Oliver276A/TinaThePageTurner/Final-Report.md

# Automatic Page Turner - Final Report

Dawson College - MakerSPACE  
Student Name: Oliver Mui  
Submitted to: Professor Joel Trudeau  
Date submitted: 2025-06-01    
       
[View on Github](https://github.com/Oliver276A/TinaThePageTurner/blob/main/Final-Report.md) or checkout the repository [here](https://github.com/Oliver276A/TinaThePageTurner).      

## 1. Introduction

One of the issues that bother many musicians is that of turning pages, which greatly inhibits their performance (to the point where in some concerts there is a dedicated person to turn the pages for the musician). Some use electronic tablets as a substitute but it is expensive and inconvenient for quick annotation. I believe that many musicians would like to be able to enjoy the convenience of having the pages turned for them while using their physical book or sheet music, and this inspired me to create this project, that is to create a prototype of an automatic page turner dedicated for musicians.   

This report will cover the planning, implementation and the results of this project, in an attempt to provide some insights on the development of such device.    

## 2. Project Description

### 2.1. Inspiration

The inspiration comes from my personal frustration over turning pages while trying to play a difficult piece. I do not own an electronic tablet, meaning my only options are to flip the pages myself or simply memorise the music.     

### 2.2. Objectives

Several similar projects exist but they present a few problems: Firstly, most of such projects are optimized for book reading and not for musicians, so they either lay completely flat, or they require an extensive setup. The one project that is made for the piano requires the pianist to attach special magnets. To me, all these reduce the attractiveness of page flipping machines to musicians.   

Thus, the goal of this project is to create a prototype of an **autonomatic** machine that is capable of turning pages while being **adapted to the needs of musicians**, that is:
- Lightweight and flexible for different needs
- Requires *minimal* setup and easy to use
- Simple, cheap and reliable
- Provides consistent result    

With limited resources, time and skills, I do not expect to create a perfectly functional machine. However, through the creation of a **basic prototype**, I hope to demonstrate that such device is feasible and can be perfected and developped into an real product, while sharing my experience which I hope would be of value to someone who wants to develop something similar.     

### 2.3. Design and Planning

The first question to answer, and this will prove to be the most important question, is how the pages should be picked up. Static electricity and magnets do not seem practical, so I decided to rely on the traditional mechanical method, which exist on many existing models - using a wheel to lift the pages.    

Then, when the pages are lifted, how should they be flipped to the left? My initial idea was to use a sliding bar. However, this will require gears and rails for the bar to slide upon, which are not only complicated, but can also end up being heavy. I opted for a stick attached to a servo in the end, which is simpler and more readily available.    

Some kind of user interaction is needed to trigger the page turn. I did not think about this in much detail as this can be any form of button or sensor depending on the need.    

Lastly, one single structure is needed to connect all these components. At first, inspired from book clips, I wanted to use those clips as the platform of my device, which allows for easy clipping to any books. However, upon further consideration, I discovered two problems: First, it would not work for books that lacks a hard cover which cannot support the weight of the device; Second, the device moves in such a big distance that a simple clip would not be enough.    

Thus, afterwards, I adopted the idea of a light platform to which books are clipped by a wheel and a stick which turn the pages. Tina "the Page" Turner was born.   

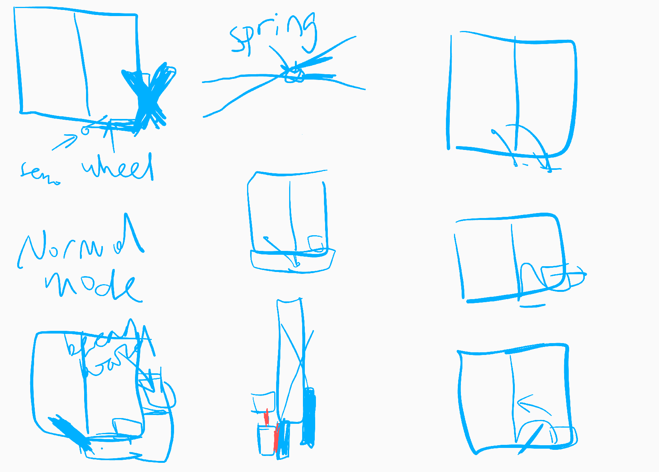
[picture p2: images/doodle.png]
Brainstorming doodle


## 3. Implementation

### 3.1. Hardware

- **Electronic Components**
    1. 180 degrees servo (Feetech FS90) - For the turning stick
    2. Continuous servo (Feetech FS90R) - For the wheel
    3. Ultrasonic sensor (HC-SR04) - Need I say more?   
- **Structural**
    1. Structural material of choice - I used some hard cardboard which is readily available but wood or metal will also work
    2. Adhesives - Some tape and some hot glue
    3. Torsion springs - This is to put pressure between the page and the wheel while allowing books to be placed on the platform; I realized it is very difficult to install torsion spring, so I came up with using a clothespeg which is readily available! (Note that the angle cannot be too small - More on this later.)
- **Tools**
    1. Scissors and cutters
    2. Hot glue gun

**Creating the Frame of the Machine**    
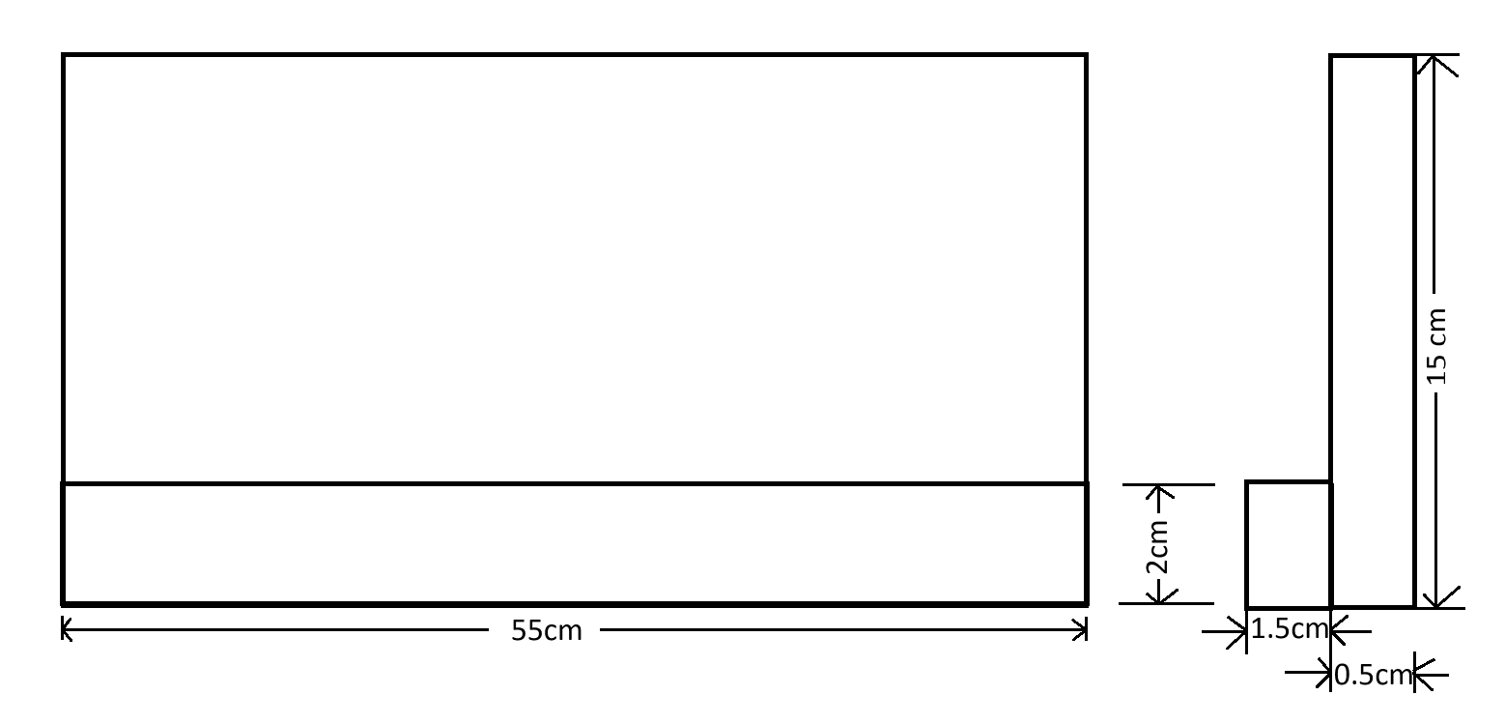
[picture p3: images/frame.png]
Diagram of the frame


**Installation of Electronic Components**   
              
*Overview*     
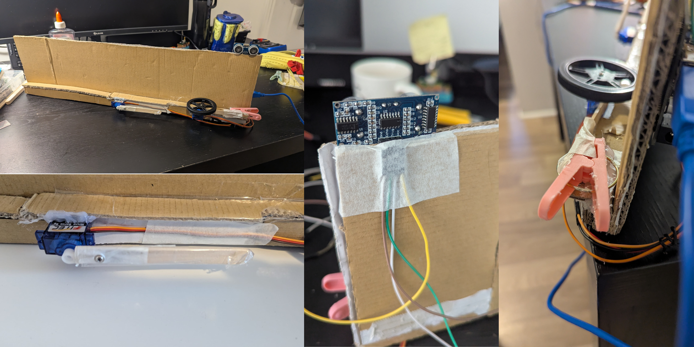
[picture p4: images/installation-photo.jpg]
Photo of Tina

*Ultrasonic sensor*    
- The ultrasonic sensor can be installed any way that is convenient
- I chose to tape the connectors on the top right of the frame simply because it is the easiest to install; It is also easy for a pianist to tilt their head to trigger the page turner     
       
*Stick*
- The stick is secured onto the 180 degree servo using a screw
- Note that the stick is wrapped with clear tape in order to make it smoother and prevent damaging the pages
- The ensemble is attached to the middle of the frame by hot glue      
         
*Wheel*
- The wheel must be secured onto the continuous servo using a screw, otherwise it could fall off
- The servo is attached to a stick, which itself is attached to the clothespeg using hot glue
- The clothespeg is attached to the horizontal platform such that the wheel touches the back platform
- A small triangular piece of cardboard was added to strengthen the connection     
          
*Arduino Uno and Breadboard*
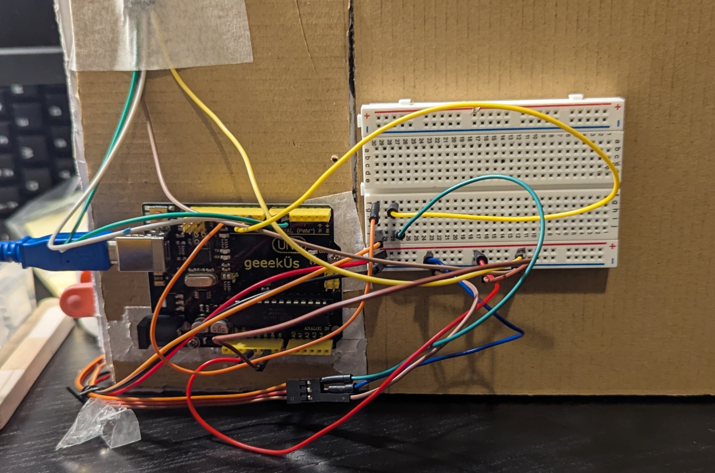
[picture p5: images/wiring-photo.jpg]
Wiring photo

- The Uno is secured by screws and the breadboard by adhesives
- The wires are hidden from view by placing the Uno and the breadboard in the back of the platform    

The wiring is shown in the following schematic:     
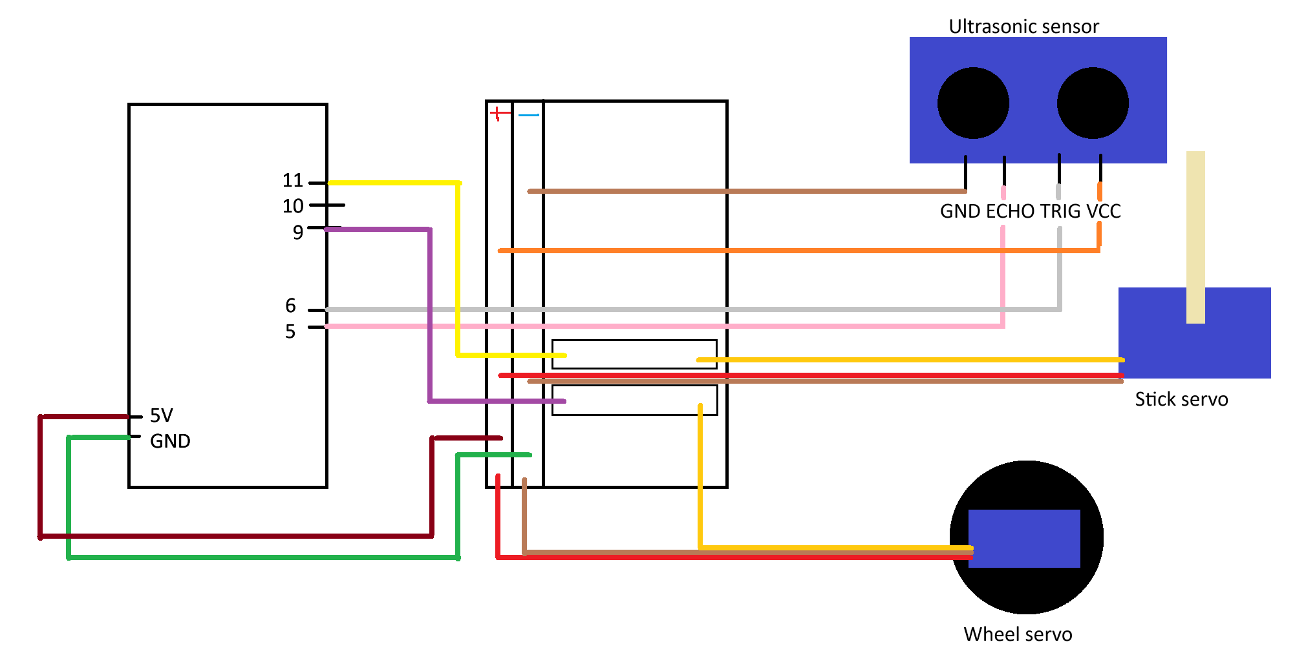
[picture p6: images/schematic.png]
Schematic diagram
  

Note that it is common practice to power servos with an external power supply, as the Arduino Uno does not provide sufficient current for the servos. However, during the course of this project, I did not notice significant power issues apart from the following: 1) The stick servo sometimes have trouble pushing the pages, especially when the page turner turns more than one pages by accident, and 2) A slight buzzing of the servos, which upon research seems to be linked to power issues. At any rate, the stick is not supposed to push more than one page, and the slight buzzing gets covered by the sound of the piano, and thus I did not connect an external power supply.    

### 3.2. Code

With the hardware installed, it was time to hop onto my laptop and start coding.     

In order to be able to incorporate servos in the program, the Arduino Servo library was included.    

I first wrote a basic program with the wheel simply turning at a certain speed and the stick pushing the pages. To my surprise it already worked but three issues arose:    

1. Machine starts right away, making it difficult to put books on the platform without accidentally triggering the page turning mechanism
    - **Solution**: This is fixed by adding an initialization mechanism. The following code allows for activating the machine by placing one's hand 5cm (not likely to be triggered by accident) within the ultrasonic sensor for 6 cumulative ticks (0.5 second each):     
    ```C++
    int i = 0;
    while(i < 6) {
        getDistance();
        if (distance < 5) {
            i ++;
            delay(500);
        }
    }
    ```
    - I did not make i go back to zero in case the sensor glitches and detects an unreasonably big distance and reset the counter again.
    - Similarly, a turning off mechanism is added but this time, the counter will reset if the sensor senses a big distance again
    ```C++
    // Turning off mechanism
    if ((distance <= 5) and (robotOn = true)) { // If very close, trigger the mechanism

        int j = 0; // Make an integer

        while(j < 6) {
            getDistance(); // Get new distance
            Serial.println(distance);
            if (distance <= 5) { // Very close
                j ++; // Count six consequetive times (3 seconds)
                delay(500);
            }
            else {break;} // If far again, proceed
        }

        if (j >= 6) {
            stick.write(0); // Stick returns to neutral position
            Serial.println("Turning off!");
            while(true) {} // If more than 3 seconds, shut down
        }
    }
    ```

2. Glitchy ultrasonic sensor readings, triggering the turning mechanism when not needed
    - **Solution**: When the ultrasonic sensor senses a distance less than 30cm, it checks shortly afterwards again. If the distance is still less than 30cm, the turning mechanism is triggered.
    ```C++
    if ((distance > 5) and (distance < 30)) { // 30 seems to be a reasonable distance to trigger the robot. Also, less than 5cm is excluded because of the turning off mechanism
    
        delay(100); // Wait for one more tick to check if glitching
        getDistance();
        Serial.println(distance);
        if ((distance > 5) and (distance < 30)) { // Not glitching, proceed
        // The page turning mechanism follows...
    ```

3. The rubber wheel fails to pick up any pages some times, and pick up more than one pages the other times
    - This issue proves to be the central challenge of the project. As it concerns both software and hardware, I will talk about this in the next section.    

### 3.3. The Wheel Dilemma

The wheel relies on static friction to pick up the page. If the friction is insufficient, pressure could be added on the wheel and the paper. However, if this is too mcuh, the device might end up turning more than one page. By doing so, friction will increase both between the wheel and the top page, and between the top page and the pages below. Therefore, I concluded that while the pressure between the wheel and the page helps increase the friction, it is best to improve the grip through wheel material or code.     

Upon some research, I found that WD-40 might help improving the wheel's grip. However, after wiping the surface of the wheel with it, I noticed no observable change in the wheel's grip, so soon I oriented to get grip by changing the behaviour of the wheel.     

I first started by adding code that makes the wheel slowly accelerates. This meant that the wheel is less likely to slide. This improved grip significantly, but there is still inconsistency.     

I then got inspired by the ABS on cars and added code that produced pulses of rotation. These short and quick rotations allow the wheel to move the page and give the wheel multiple opportunities to grip the page.     

Finally, these two features are combined. The pulses slowly increase in speed to avoid gripping on the next page. This improved consistency immensely:
```C++
stick.write(0); // First, the stick goes to the horizontal position, ready to lift a page
delay(250); // Wait for the stick to arrive to the right

// Jolts a bit to get grip
for (int w = 90; w <= 125; w = w + 5) {
    wheel.write(w);
    delay(50);
    wheel.write(90);
    delay(50);
}

wheel.write(160);
delay(100);
wheel.write(96); // Go slowly to let stick go! 
```
I also made the wheel go slowly in case a page is stuck under the wheel.

### 3.4. Sensor Documentation

Only one ultrasonic sensor was used in the program. It works as follows:   
1. Sensor sends a pulse and awaits the echo; The distance is calculated from the time difference
2. 3 cumulative seconds of detection within 5cm initiate the device
3. Upon detection within 30cm, the device double checks for glitches, then triggers the page turning mechanism
4. Upon detection within 5cm, the device counts 6 consecutive ticks of 0.5 seconds and shuts off; If during the counting, the distance becomes long again, the counter is reset     

```C++
void getDistance() {
  digitalWrite(trigPin, LOW);
  delayMicroseconds(2);
  digitalWrite(trigPin, HIGH);
  delayMicroseconds(10);
  digitalWrite(trigPin, LOW);
  duration = pulseIn(echoPin, HIGH);
  distance = (duration * 0.034) / 2;
}
```

For the code of the detection, please refer to the [code file](/ttpt.ino) or to section 3.2.   

## 4. Results

Click [here](/images/demo-video.mp4) for the demo video or [here](https://youtu.be/T23dxvnY-iA) for the demo video with commentary.

### 4.1. Analysis

Tina was able to complete its basic objectives. It was able to flip pages under the condition that they are not too hard or stuck together. It seems to work better with a book that has been flipped frequently. Shuffling the pages a bit beforehand also helps.     

The number of pages it flips is still inconsistent, but its rate of success is much higher than in the initial development phase. The following are the main reasons for the inconsistency:    
- Tina is unable to grab the page because:
    - It does not have enough grip
    - It does have enough grip but the page is stuck below the wheel
    - It does have enough grip and moves the page but the stick was not able to lift it or turn it
- Tina turns more than one page at the same time because:
    - The turning time is too long and the wheel grabs the next pages
    - The pages are stuck together     

Tina is reactive. The triggering mechanism was easy. With the double-check preventing glitching, Tina seldoms turns pages unpredictably. Turning on and off the device could be annoying at times due to glitching (sometimes Tina would not turn off even after putting my hand in front of the sensor for 10 seconds), but it seems to be adequate in general.    

Structurally, Tina presents a few weak points listed as follows:
1. The adhesive holding the clothespeg may not be able to resist such a strong shear force
2. The quality of the body is admittedly mediocre     
Many components that were held on by hot glue or tape were later changed to being held on by screws which seemed much more reliable.    

### 4.2. Discussion and Conclusion

Based on the findings, I propose the following improvements to the project:
1. A grippier wheel
2. More sensors (e.g. pressure sensor, another US sensor, etc.) to detect the status of the page turning motion
    - Then the rotating time or even the rotating mechanism can be adapted to each page as needed, as some are more loose and some are tighter
3. Placing the stick servo vertically lower to reduce the angle to reduce creasing of the pages and to improve the chances of the stick lifting a page
4. For the wheel, a clip component (replacing the clothespeg) that is better attached and more resistant
5. An optimized body frame design (take out unnecessary bits and weight)          

In addition, there are numerous potential development to Tina, including but not limited to:
1. Different user input: e.g. A sensor that detects foot motion, automatic counting, MIDI, etc.
2. Reverse page turning
3. Adaptation for other instruments e.g. To fit on sheet music stands          

Tina was able to paint an optimistic picture for the development of an automatic page turning device. Although by no means perfect, Tina fulfilled its purpose of showing that the making of such a device is feasible at a low cost. The fact that Tina succeeded to carry out basic fundamental tasks means that with more and better resources and more time, a fully functional page turner that is practical, cheap, consistent, simple and reliable can be developed.    

### 4.3. References

- Page Turner. "Automatic Page Turner, by Page Turner Co., for Pianists and Musicians," *YouTube*, 9th Oct 2020, https://youtu.be/G2RFGrQZSTo?si=Q4xsxEa2sr18Slvu. Accessed 2nd Jun 2025.
- jabish albuladora. "Automatic Page Turner Ph," *YouTube*, 21st Jun 2015, https://youtu.be/CKVff6EtwCs?si=Kb442-sn2RrqLdt4. Accessed 2nd Jun 2025.
- Rehabmart. "PageFlip Automatic Page Turner2.flv," *YouTube*, 24th Feb 2010, https://youtu.be/1Xn1iUqC9gk?si=drv0QgZd-4C8tCpC. Accessed 2nd Jun 2025.
- PrintLab. "3D Printed Auto Page Turner," *YouTube*, 4th Dec 2023, https://youtu.be/WpUmWCApFB4?si=h_dbwm2LjK1nmO1O. Accessed 2nd Jun 2025.
- "Hey folks, Any idea how to increase the tire grip on my RC car? It’s pretty fast goes at 40km/h but the tires are so bad, and good tires are way too expensive than my RC cars due to import duties. Please share your suggestions!," r/rccars, *Reddit*, https://www.reddit.com/r/rccars/comments/11sehz6/hey_folks_any_idea_how_to_increase_the_tire_grip/. Accessed 2nd Jun 2025.                 

### 4.4. Acknowledgements

- Professor Manuel Toharia
- Professor Joel Trudeau           
        
And thank you, Lenie, for being there for me always! :)
