Oliver276A/TinaThePageTurner/images/overview.jpg

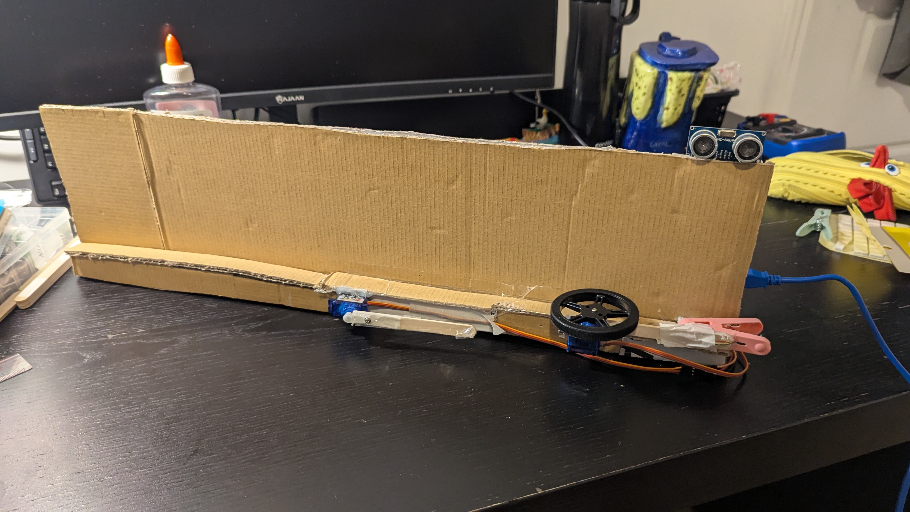
images/overview.jpg
