Oliver276A/TinaThePageTurner/images/stick.jpg

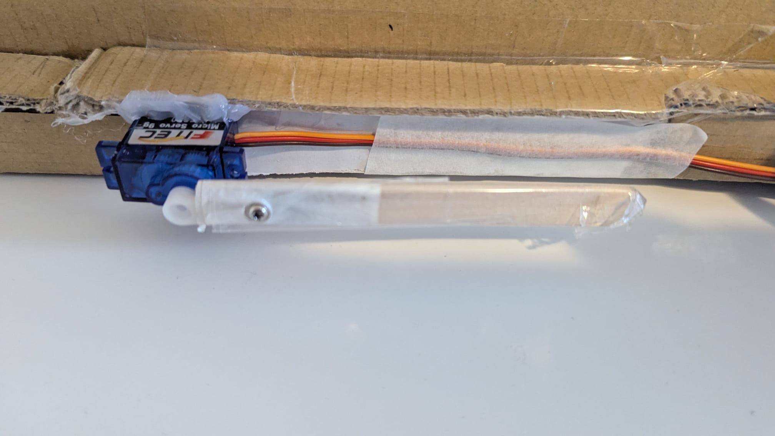
images/stick.jpg
