Oliver276A/TinaThePageTurner/images/us-sensor.jpg

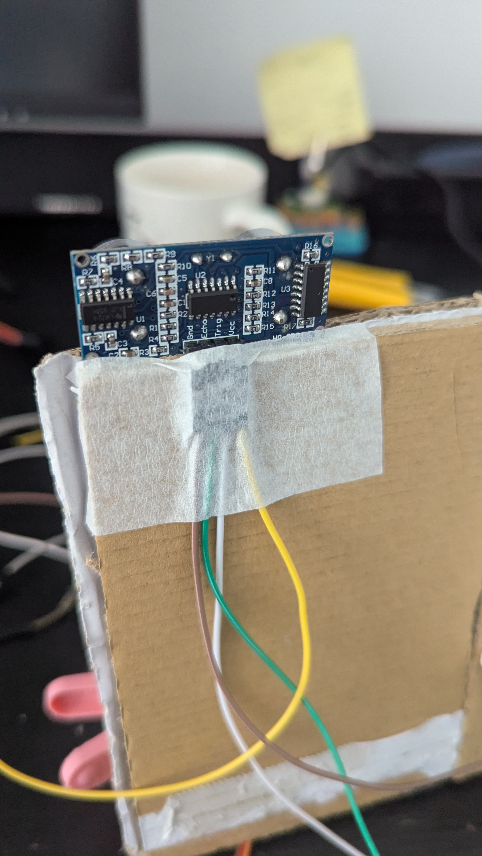
images/us-sensor.jpg
