Oliver276A/TinaThePageTurner/images/wheel-and-clothespeg.jpg

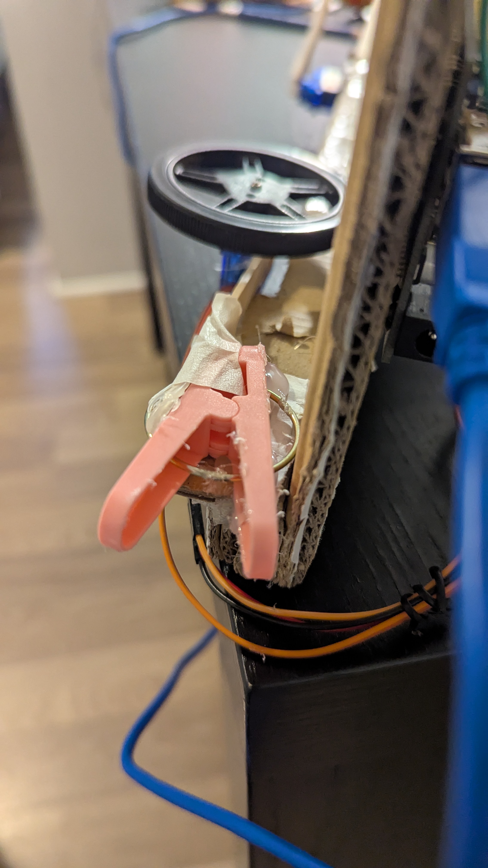
images/wheel-and-clothespeg.jpg
