Oliver276A/TinaThePageTurner/(commit log)

2025-05-27 added arduino code
2025-05-28 added basic arduino code for setup: stick servo and us sensors are working but wheel not working
    [ttpt.ino]
2025-05-28 added basic backbone code; Stick working; Fixed a bug in turning off mechanism (getDistance in while loop)
    [ttpt.ino]
2025-05-28 Things to do: Get the wheel working + glitchy page flip
    [ttpt.ino]
2025-05-28 Fixed glitchy flilp (by adding a second check); Problem: servo buzzing affecting US sensor
    [ttpt.ino]
2025-05-28 new servo is working; Added delay for stick to arrive
2025-05-28 worked on czerny (not consistent); changed stick angle and speed to better fix pages
    [ttpt.ino]
2025-05-28 last commit before trying out variable speed wheel
2025-05-30 latest working version after structural reinforcement; pulse and slow turn
    [ttpt.ino]
2025-05-31 added more issues and diagrams
    [ttpt.ino]
2025-06-01 added installation pictures and schematic
